anuthrak/eg-rocket-tvc/releases/batch-001_2026-10-30/drawings/SLDP-AV-001_avionic-sled.png

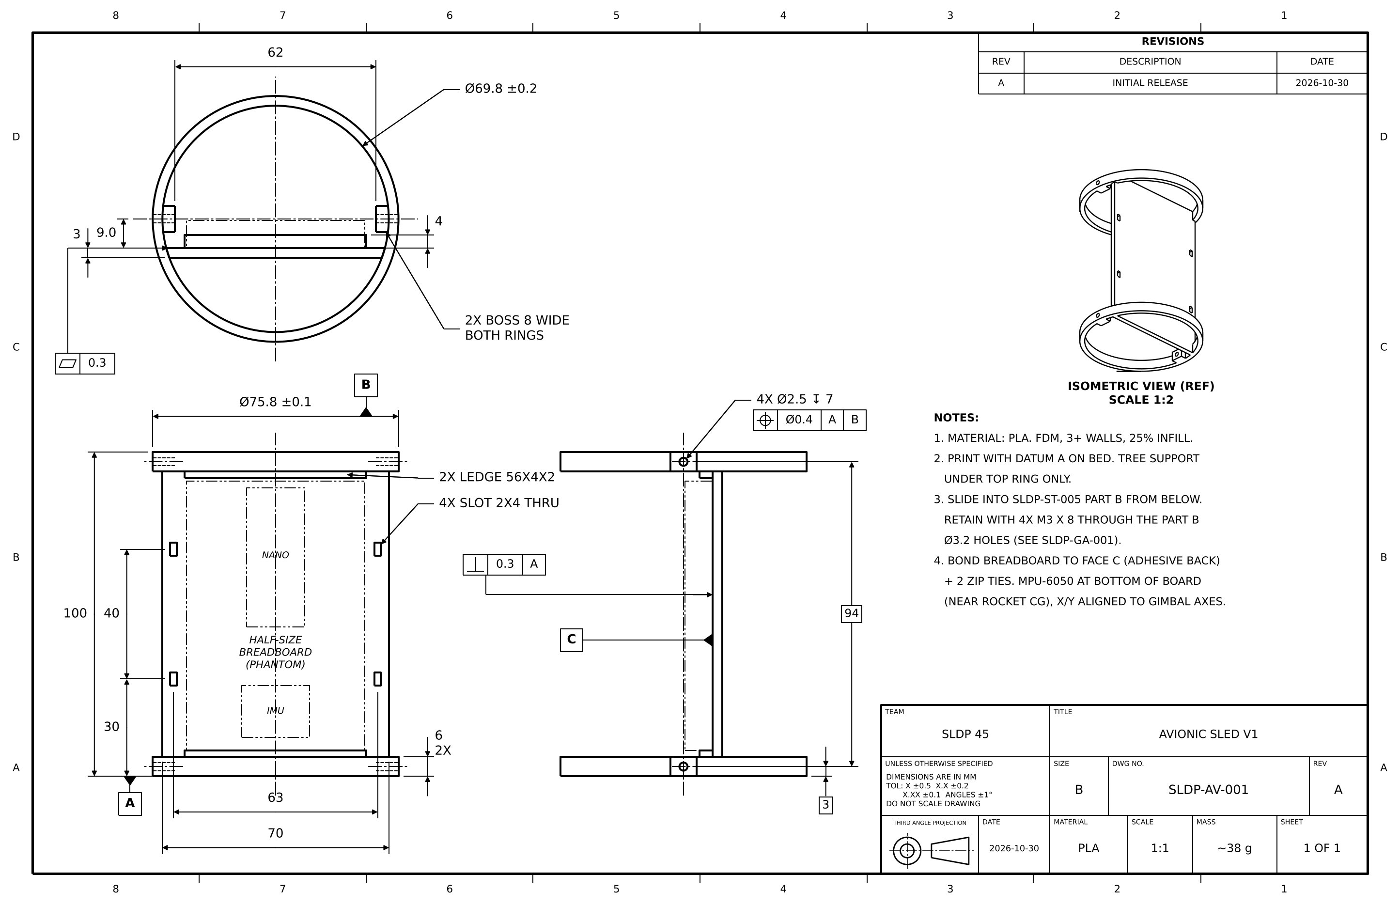
releases/batch-001_2026-10-30/drawings/SLDP-AV-001_avionic-sled.png
