anuthrak/eg-rocket-tvc/releases/batch-001_2026-10-30/drawings/SLDP-GA-001_rocket-ga_sheet2.png

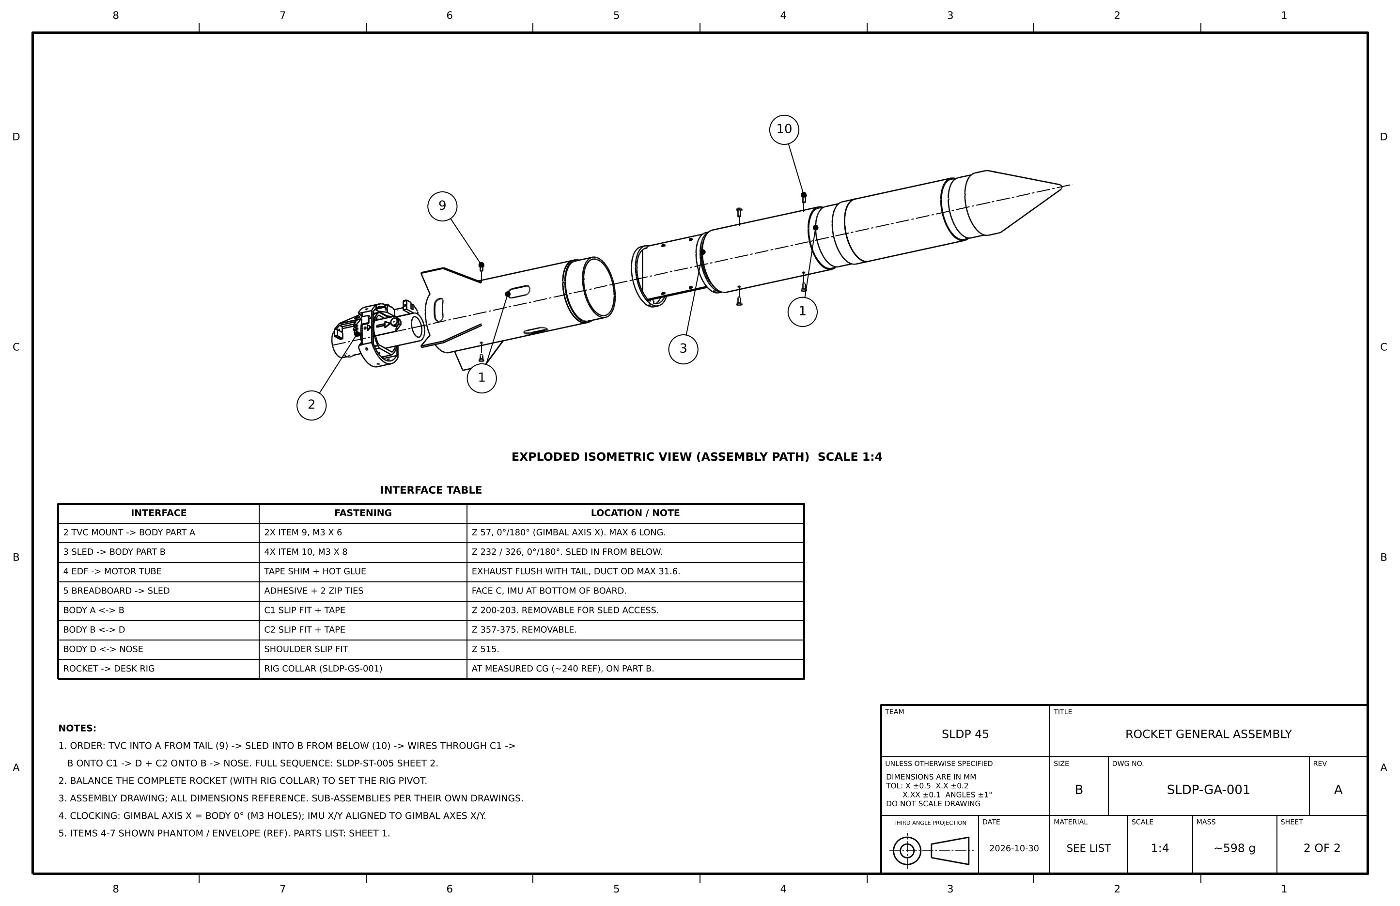
releases/batch-001_2026-10-30/drawings/SLDP-GA-001_rocket-ga_sheet2.png
