anuthrak/eg-rocket-tvc/releases/batch-001_2026-10-30/drawings/SLDP-TVC-001_tvc-mount-ga_sheet1.png

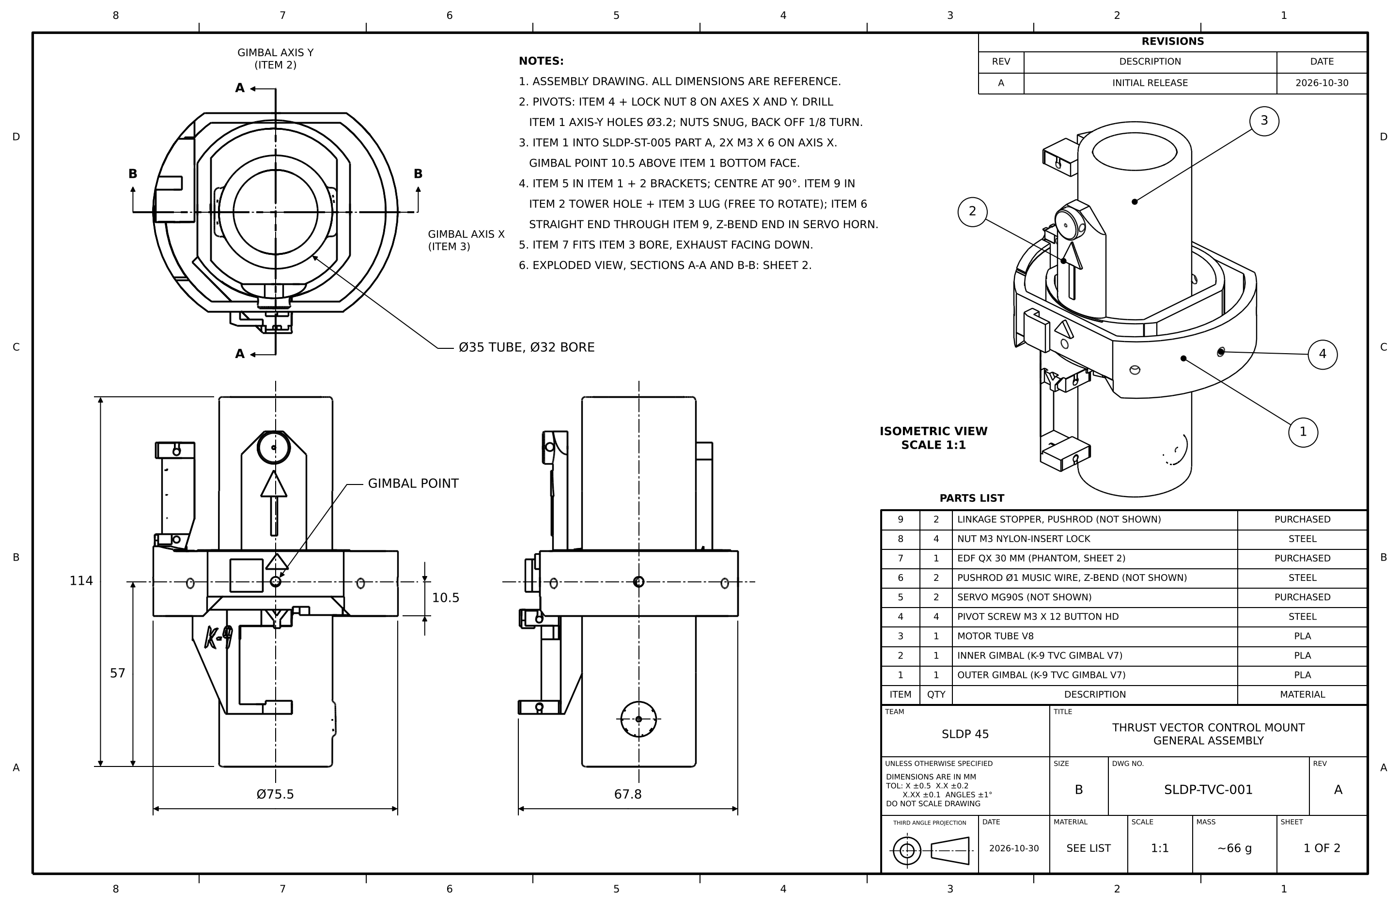
releases/batch-001_2026-10-30/drawings/SLDP-TVC-001_tvc-mount-ga_sheet1.png
