anuthrak/eg-rocket-tvc/releases/batch-001_2026-10-30/cad/SLDP-AV-001_avionic-sled.step

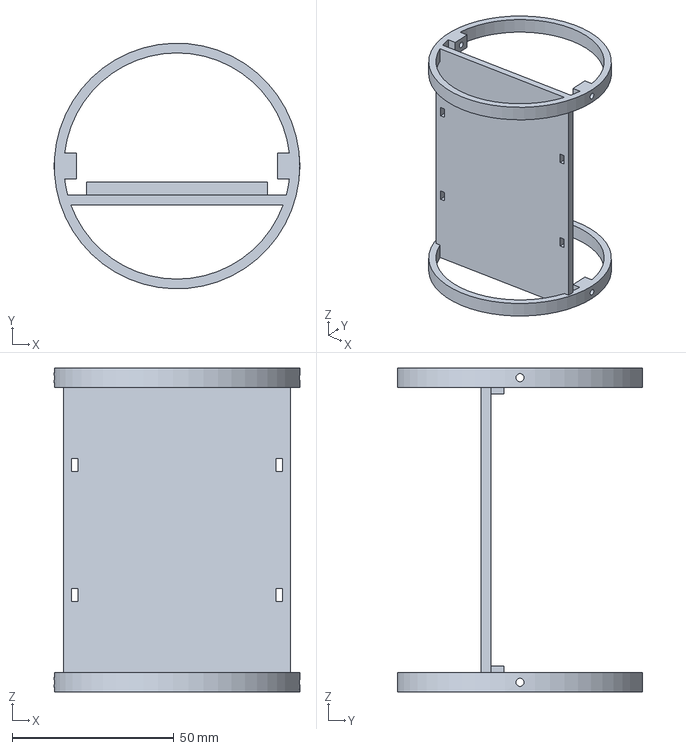
[picture p6: CAD file, 2026-11-02]
releases/batch-001_2026-10-30/cad/SLDP-AV-001_avionic-sled.step
75.8 x 75.8 x 100.0 mm
