anuthrak/eg-rocket-tvc/releases/batch-001_2026-10-30/print/SLDP-TVC-001_motor-tube-v8.stl

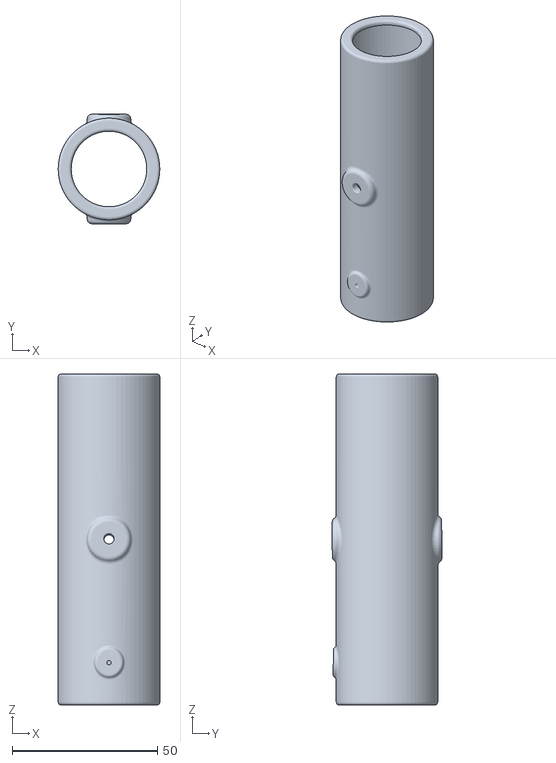
[picture p7: CAD file, 2026-11-02]
releases/batch-001_2026-10-30/print/SLDP-TVC-001_motor-tube-v8.stl
35.0 x 37.7 x 114.0
