anuthrak/eg-rocket-tvc/releases/batch-001_2026-10-30/cad/SLDP-ST-005_C2-interstage-coupler.step

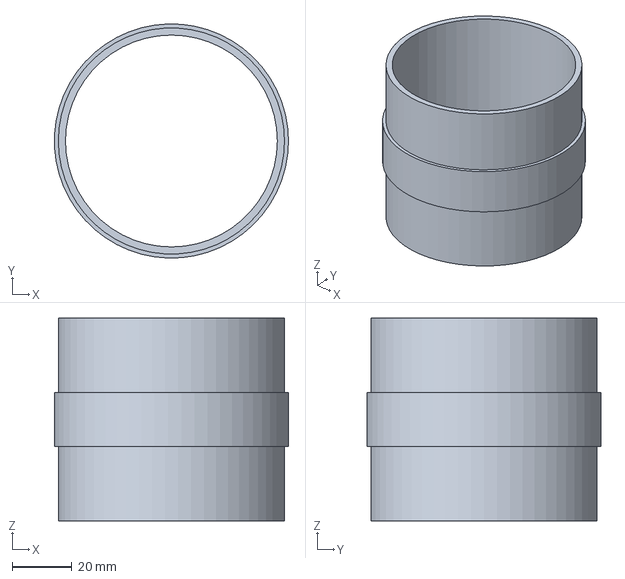
[picture p8: CAD file, 2026-11-02]
releases/batch-001_2026-10-30/cad/SLDP-ST-005_C2-interstage-coupler.step
78.5 x 78.6 x 68.0 mm
