anuthrak/eg-rocket-tvc/releases/batch-001_2026-10-30/print/SLDP-ST-005_D-upper-body.stl

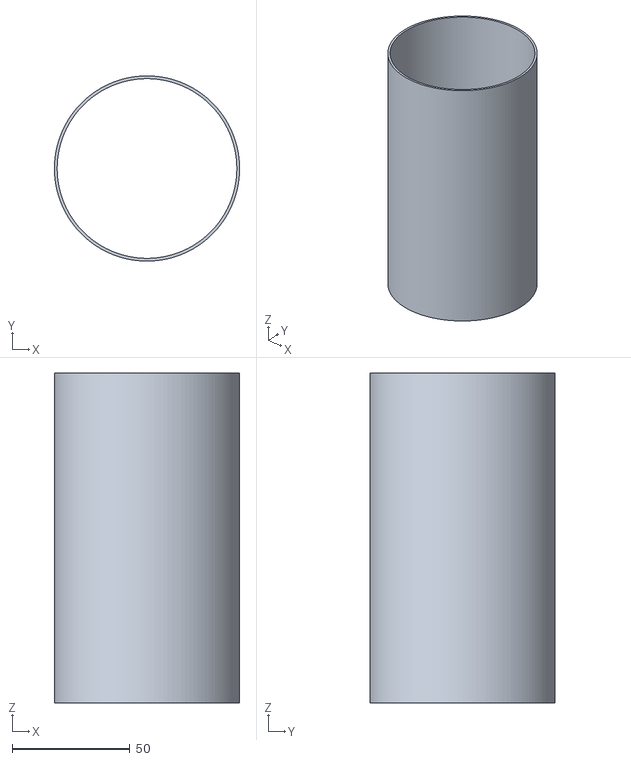
[picture p9: CAD file, 2026-11-02]
releases/batch-001_2026-10-30/print/SLDP-ST-005_D-upper-body.stl
78.6 x 78.6 x 140.0
