anuthrak/eg-rocket-tvc/releases/batch-001_2026-10-30/cad/SLDP-ST-005_B-avionics-bay.step

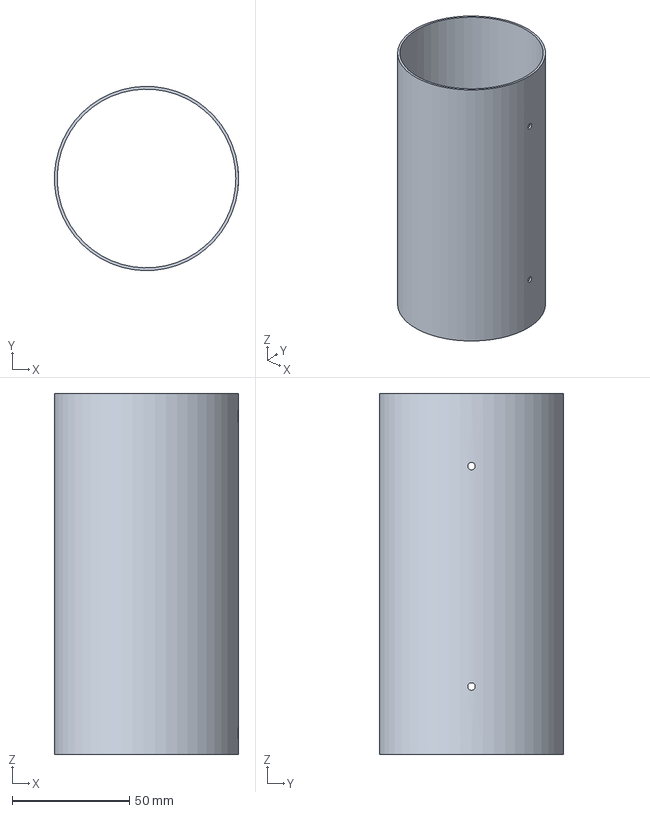
[picture p10: CAD file, 2026-11-02]
releases/batch-001_2026-10-30/cad/SLDP-ST-005_B-avionics-bay.step
78.6 x 78.6 x 154.0 mm
