anuthrak/eg-rocket-tvc/releases/batch-001_2026-10-30/print/SLDP-ST-005_E-nose-cone.stl

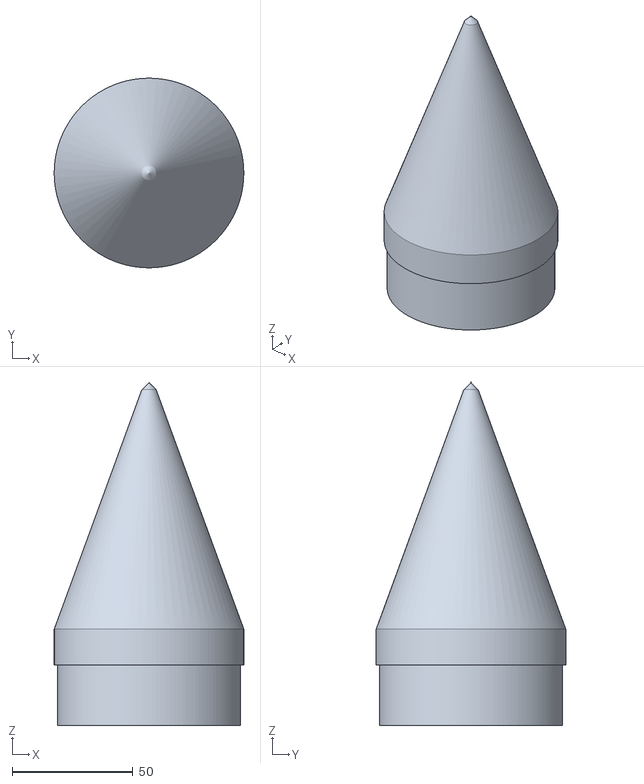
[picture p11: CAD file, 2026-11-02]
releases/batch-001_2026-10-30/print/SLDP-ST-005_E-nose-cone.stl
78.6 x 78.6 x 142.2
