anuthrak/eg-rocket-tvc/releases/batch-001_2026-10-30/print/SLDP-ST-005_test-coupler-C1.stl

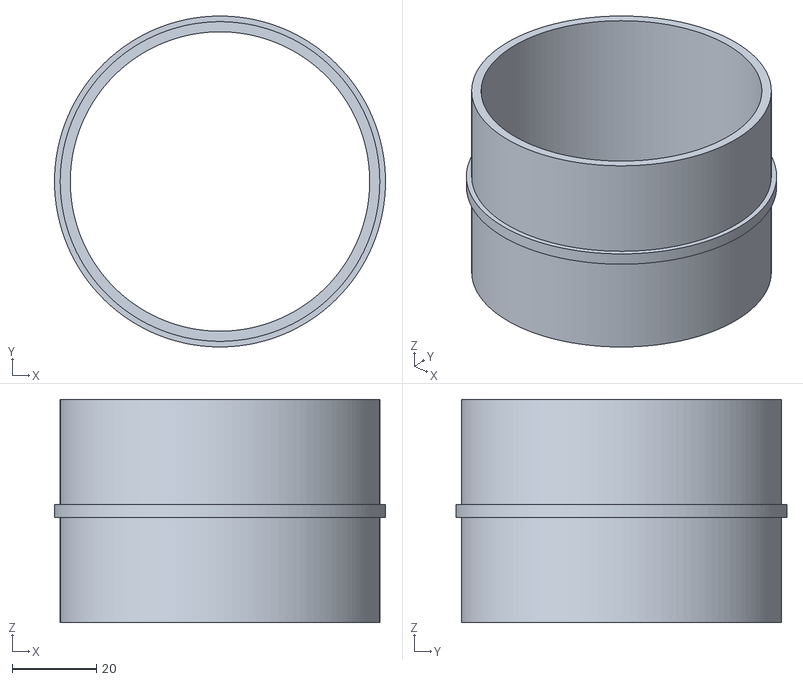
[picture p12: CAD file, 2026-11-02]
releases/batch-001_2026-10-30/print/SLDP-ST-005_test-coupler-C1.stl
78.6 x 78.6 x 53.0
