anuthrak/eg-rocket-tvc/releases/batch-001_2026-10-30/drawings/SLDP-GA-001_rocket-ga.pdf

B

## REVISIONS

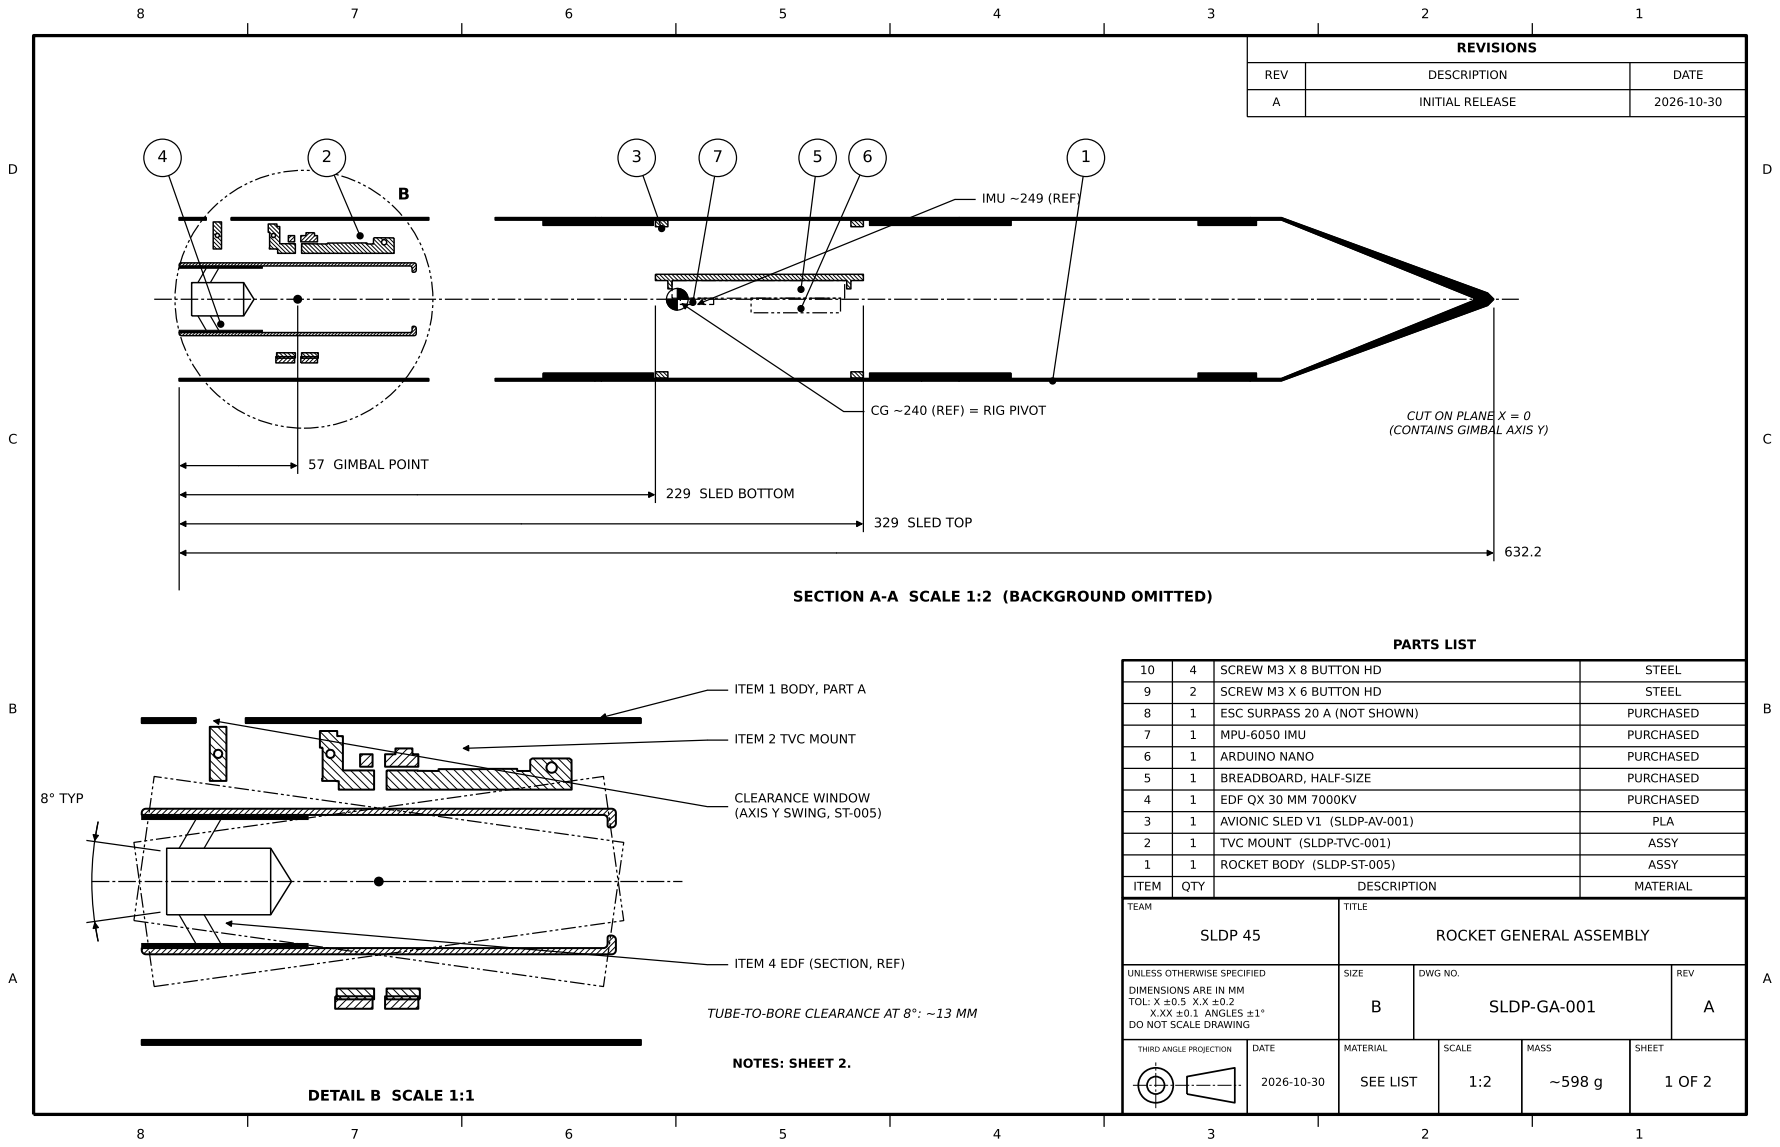
[picture p13: page 1]
57 GIMBAL POINT; 229 SLED BOTTOM; 329 SLED TOP; IMU ~249 (REF); 8° TYP; DETAIL B SCALE 1:1; NOTES: SHEET 2.; REV; DESCRIPTION; DATE; INITIAL RELEASE; TEAM; SLDP 45; TITLE; SIZE; DWG NO.; SLDP-GA-001; MATERIAL; SEE LIST; SCALE; MASS; SHEET; ITEM; QTY; ROCKET BODY (SLDP-ST-005); ASSY; TVC MOUNT (SLDP-TVC-001); AVIONIC SLED V1 (SLDP-AV-001); PLA; EDF QX 30 MM 7000KV; PURCHASED; BREADBOARD, HALF-SIZE; ARDUINO NANO; MPU-6050 IMU; ESC SURPASS 20 A (NOT SHOWN); SCREW M3 X 6 BUTTON HD; STEEL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

CG ~240 (REF) = RIG PIVOT

CUT ON PLANE X = 0
(CONTAINS GIMBAL AXIS Y)

SECTION A-A SCALE 1:2 (BACKGROUND OMITTED)

ITEM 1 BODY, PART A

ITEM 2 TVC MOUNT

CLEARANCE WINDOW
(AXIS Y SWING, ST-005)

ROCKET GENERAL ASSEMBLY

ITEM 4 EDF (SECTION, REF)

UNLESS OTHERWISE SPECIFIED

DIMENSIONS ARE IN MM
TOL: X ±0.5 X.X ±0.2
X.XX ±0.1 ANGLES ±1°
DO NOT SCALE DRAWING

TUBE-TO-BORE CLEARANCE AT 8°: ~13 MM

THIRD ANGLE PROJECTION

9

10

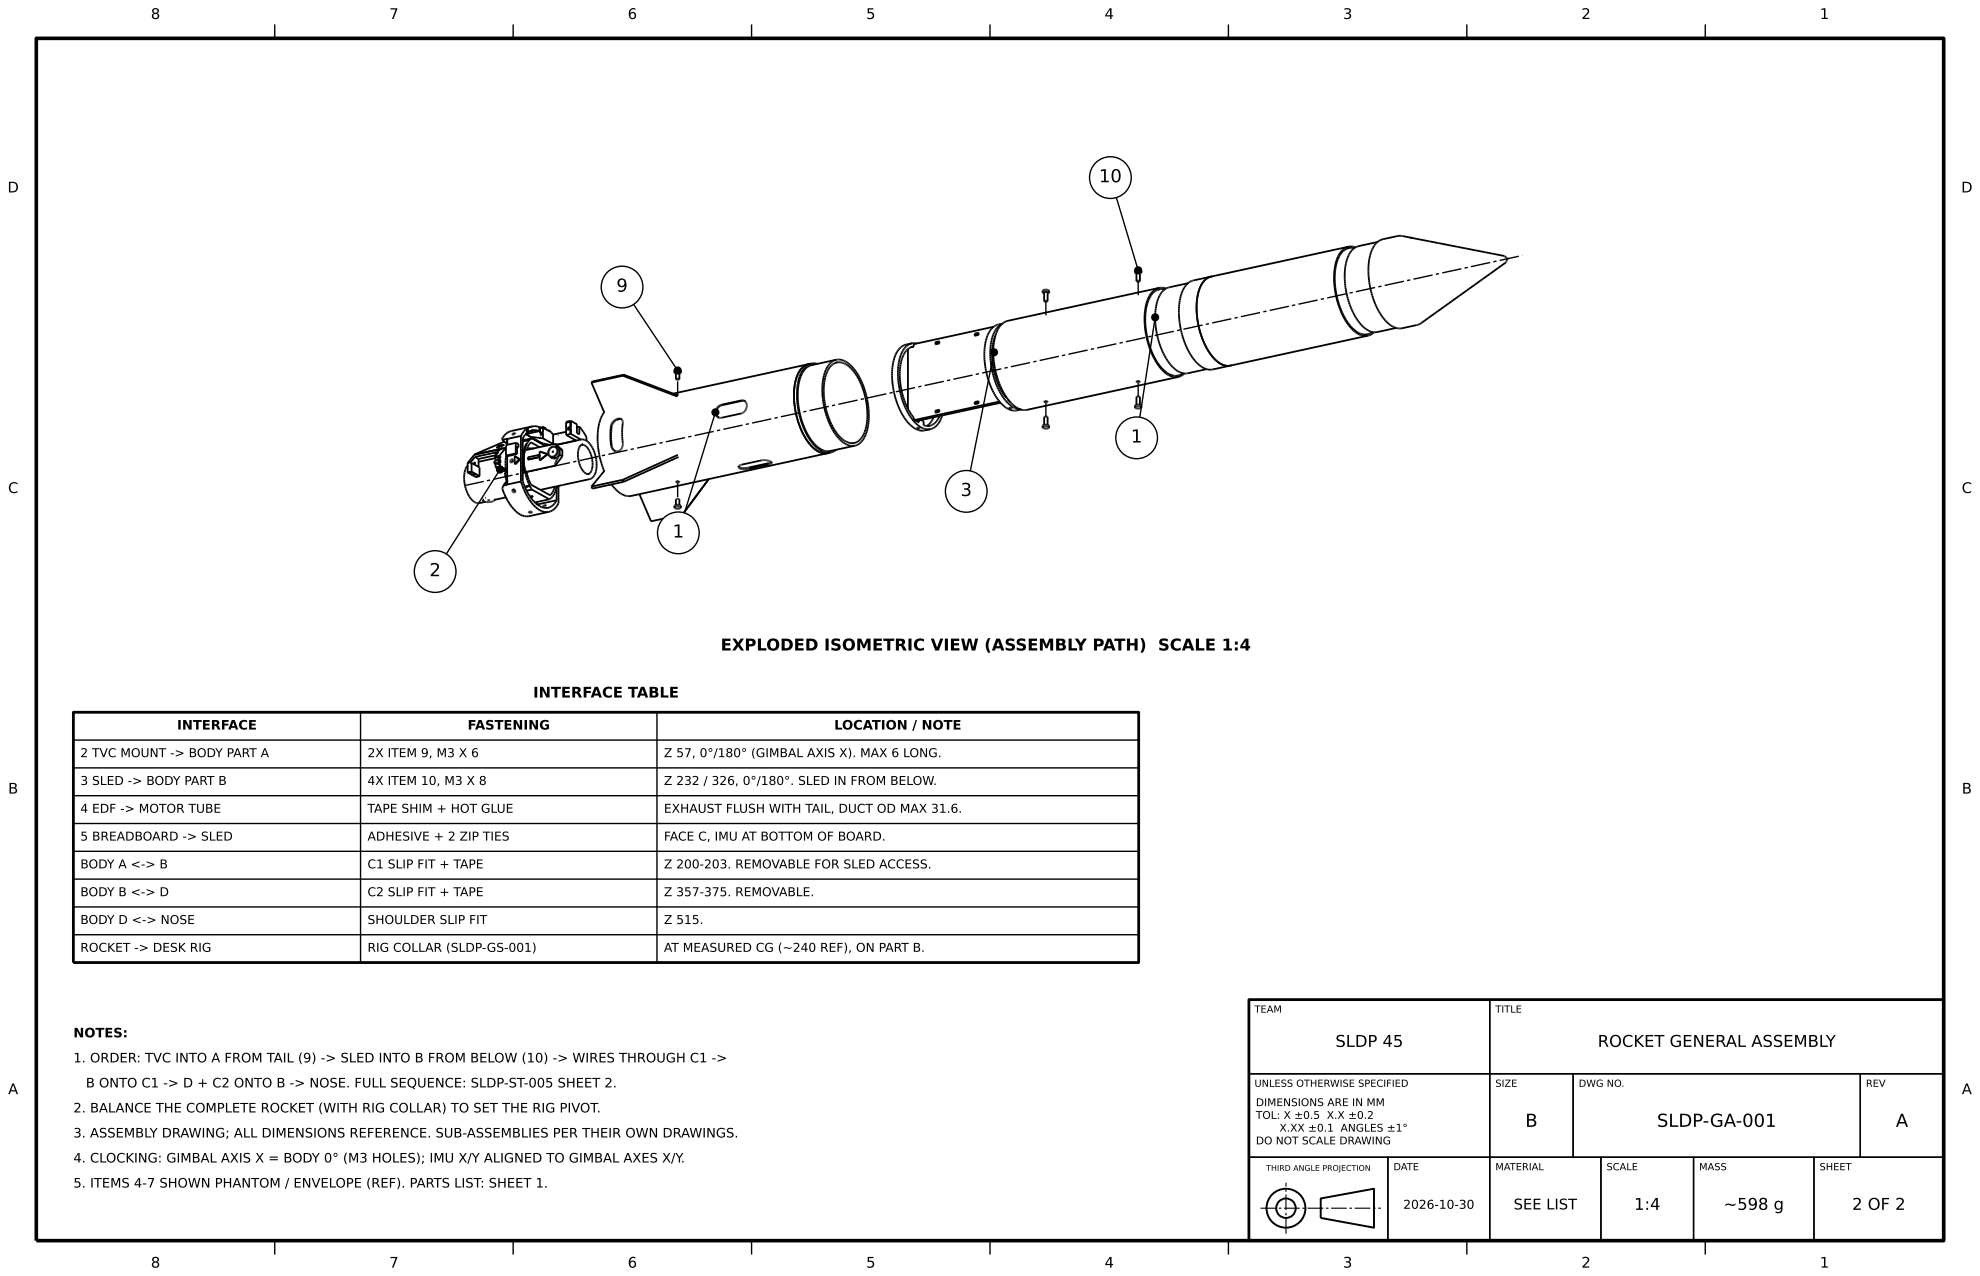
[picture p14: page 2]
INTERFACE; FASTENING; LOCATION / NOTE; 2 TVC MOUNT -> BODY PART A; 2X ITEM 9, M3 X 6; Z 57, 0°/180° (GIMBAL AXIS X). MAX 6 LONG.; 3 SLED -> BODY PART B; 4X ITEM 10, M3 X 8; Z 232 / 326, 0°/180°. SLED IN FROM BELOW.; 4 EDF -> MOTOR TUBE; TAPE SHIM + HOT GLUE; EXHAUST FLUSH WITH TAIL, DUCT OD MAX 31.6.; 5 BREADBOARD -> SLED; ADHESIVE + 2 ZIP TIES; FACE C, IMU AT BOTTOM OF BOARD.; BODY A <-> B; C1 SLIP FIT + TAPE; Z 200-203. REMOVABLE FOR SLED ACCESS.; BODY B <-> D; C2 SLIP FIT + TAPE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

EXPLODED ISOMETRIC VIEW (ASSEMBLY PATH) SCALE 1:4

ROCKET GENERAL ASSEMBLY

1. ORDER: TVC INTO A FROM TAIL (9) -> SLED INTO B FROM BELOW (10) -> WIRES THROUGH C1 ->

B ONTO C1 -> D + C2 ONTO B -> NOSE. FULL SEQUENCE: SLDP-ST-005 SHEET 2.

UNLESS OTHERWISE SPECIFIED

2. BALANCE THE COMPLETE ROCKET (WITH RIG COLLAR) TO SET THE RIG PIVOT.

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

3. ASSEMBLY DRAWING; ALL DIMENSIONS REFERENCE. SUB-ASSEMBLIES PER THEIR OWN DRAWINGS.

4. CLOCKING: GIMBAL AXIS X = BODY 0° (M3 HOLES); IMU X/Y ALIGNED TO GIMBAL AXES X/Y.

THIRD ANGLE PROJECTION

5. ITEMS 4-7 SHOWN PHANTOM / ENVELOPE (REF). PARTS LIST: SHEET 1.
