anuthrak/eg-rocket-tvc/(commit log)

2026-10-26 Restyle visualizer: black panels, condensed type, color-coded readouts, status pills
    Adds max pitch/yaw readouts, a link clock and feed rate in the header, a chart grid, and green done/next markers on the mission timeline. Layout and functions unchanged.
2026-10-26 Bring back the bottom mission HUD; freeze header layout
    Wide screens show the round gauges, big clock and timeline again. The top strip now carries only what the bottom HUD doesn't: next event with countdown, max speed, max altitude, peak gimbal, engine state. Header: labels that swap text get a min-width of their longest version, the status strip uses fixed-width value slots, and the demo pill's space is always reserved, so nothing shifts when switching tabs or as digits change.
2026-10-26 Fit the overview camera to the area not covered by HUD panels
    The overview now measures the gap between the bench panel, minimap/events list, controls and bottom HUD, centres the picture there with a view offset, and zooms out until Earth, the transfer orbit and the Moon fit inside it.
2026-10-26 Add loading screen with two looks (fuel, mission arc) and a temporary preview toggle
    Fuel: line drawing of the bench rocket whose two tanks fill with the pitch-blue and yaw-orange data colours, finishing with a ±8° nozzle gimbal check. Arc: the Earth-to-Moon path traced by the ship marker, ticking off milestones, finishing with a touchdown ring. Progress follows the real load steps (Three.js download, bench rig, Earth and Moon textures, transfer orbit); it's timer-driven so it completes in background tabs, shows for at least 1 s, skips the finale on same-session reloads, and lets a click dismiss it if the 3D library hasn't arrived after 15 s. Footer buttons (temporary) replay either look a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
2026-10-26 Split visualizer into six files; move firmware; add versioning
    visualizer/: index.html (markup), style.css, loader.js, main.js (entry, tabs, VERSION), bench.js (initBench), mission.js (initMission). Same behaviour; nothing runs on import, main.js calls each part in order and reports loader steps.
    Firmware moved to firmware/nano_tvc/nano_tvc.ino with FW_VERSION 1.0.0 printed at boot; the LINK panel shows it. Fuel loader is always the default (footer buttons only replay). Fixes the Bench header wrapping onto two lines at some widths. Adds CHANGELOG.md and README sections for the layout, running locally and releasing.
2026-10-26 Compact Mission tab top on phones: one-line header, icon controls
    Phones and short windows: title shortens to TVC, status shrinks to its dot, Connect + baud hide where USB Web Serial can't work, sim and bench controls become line-icon buttons (labels kept for screen readers), the mini bench panel is replaced by a one-line P/Y readout, and callouts move up. Desktop is unchanged.
2026-10-26 Mission first and default; Bench gets left and right sidebars
    Tab order is Mission, Bench; a fresh visit opens Mission (returning Bench visitors still get Bench). Bench sidebar split around the 3D view: left = readouts, chart (fills spare height), input options; right = gimbal and link tables plus help. Neither sidebar scrolls down to ~640px-tall windows: below 820px tall the help box moves into Connect's tooltip and rows tighten. Shorter roll footnote and servo-mode label; help text no longer mentions the removed Processing sketch. Keeps the page title rename.
2026-10-26 Bench: gimbal dial and serial log; smoother loading bar
    Right sidebar: a gimbal dial (nozzle position inside the ±45° ring, with a short trail) tops the Gimbal panel, and a serial log (last 200 lines, follows new lines unless scrolled up, boot messages highlighted) replaces the single-line box and fills the remaining height. Help shows only on screens >= 1000px tall (otherwise it's Connect's tooltip); baud/format rows hide below 820px since they're in the header.
    Loader: eases toward each checkpoint with a speed limit and keeps creeping toward the next one, runs on animation frames when visible (timer when hidden, where it skips easing), and texture generation works in ~50 ms slices so th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
2026-10-26 Keep the Mission camera out of planets; limit Bench zoom
    Mission: Earth and the Moon each get a thin springy shell above the surface. Dipping into it, the camera is pushed back out by a slightly underdamped spring (a small bounce, not a dead stop), sub-stepped so it behaves the same at any frame rate; a hard floor just above the surface means it can never get inside. Shells sit below the pad and landing heights so the low chase views still work.
    Bench: orbiting stays a free 360 degrees; zoom is limited to 1.2-11 units (more on tall, narrow windows so the rocket still fits), in proportion to the 8x8 floor grid, and panning is fenced to the grid.
2026-10-27 Mission camera: stop-and-bounce instead of sliding; rocket and tower are solid
    Camera colliders now cover Earth, the Moon, the rocket stack (whole stack until stage separation, then the upper stage) and the launch tower. A frame whose orbit/zoom input pushes the camera deeper into a body's soft zone is rejected, so the camera stops where it touched instead of sliding along the surface; first contact gives a small outward kick, and a sub-stepped spring settles it at the zone edge. Camera mode switches skip the check so they can't be undone by it.
2026-10-27 Mission camera collisions: dead stop instead of bounce
    Removes the outward kick and spring, which jittered when users kept dragging into a body. Now a frame that would put the camera inside a clearance zone keeps only the parts of the move that don't (orbit around the target at the same height, zoom out), so the camera holds still where it touched while sideways orbiting and pulling away still work. If the scene itself moves the camera inside (e.g. the rocket), it's placed straight back on the edge. Clearances: Earth 0.2, Moon 0.1, rocket and tower 0.06.
2026-10-27 Intro transition after the loading screen; Launch loader preview
    When the loader fades, Mission opens with a camera fly-in from a wide shot of Earth to the chase view (~1.8 s, controls paused until it lands) while the HUD boots in: panels fade and rise one after another, the event list cascades and the timeline markers light up left to right. Bench gets the HUD boot only. Same-session reloads get a quick version (~0.4 s); 'reduce motion' keeps the plain fade.
    Footer gains a Launch preview: the fuel loader with an ignition + launch-out finale (plume lights, rocket shoots off-screen), followed by the transition.
    The 3D scenes now skip drawing while the loader fully covers them (after one war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
2026-11-01 Bench gimbal calibration; firmware v1.2.0 serial commands + EEPROM config
    - Bench: Gimbal -> Calibrate opens a five-step panel over the 3D view
    (centre, level, sensor axes, servo direction, save)
    - Firmware v1.2.0: CAL/RUN/GET/SET/LEVEL/PULSE/SAVE/LOAD/DEFAULTS over serial,
    config stored in EEPROM; servos named by axis (D9 = X, D10 = Y)
2026-11-02 Release v2.4.0
    Bench gimbal calibration and firmware v1.2.0; bump VERSION and date the changelog entry.
2026-11-02 Firmware v1.3.0: any IMU mounting, tilt abort, PID, writeMicroseconds
    - LEVEL detects which sensor axis is up; SET UP / SET ROT map the sensor to the rocket frame
    (CFG gains up,rot at the end); the calibration sensor step corrects a turned sensor itself
    - Tilt abort at 25 deg (ABORT,TILT / ABORT,CLEAR), shown in the serial log
    - PID with the project-summary starting gains, scaled by thrust; servo pulses in microseconds;
    linkage ratio default 4.0 (0.2-8) with a laser measuring helper in Calibrate -> Save
    - Axis naming documented against the drawings (X servo drives pivot axis Y)
2026-11-02 One repo for the whole project: CAD, drawing release, docs
    - cad/: CadQuery models and drawing generators, one copy of the shared helpers (cad/lib),
    vendor K-9 gimbal files; scripts find each other through cad/lib/paths.py
    - releases/batch-001_2026-10-30: drawings, print STLs and STEP, renamed to the hyphen convention
    - docs/: corrected project summary (budget, schedule, roles, requirements), BOM, updated drawing standard
    - README covers the whole project; CLAUDE.md maps the sources of truth
    - Submissions, admin and old iterations stay local (gitignored)
2026-11-05 Firmware v1.4.0: tilt abort off for hand testing
    Add TILT_ABORT_ENABLED (false) so the gimbal keeps steering at any tilt,
    clamped to +-8 deg. The abort code is unchanged; turn it back on before
    the motor runs.
2026-11-05 Free-test mode and trim fix; firmware v1.5.0
    FREE ON|OFF and a Bench button for tilting the rocket by hand: no tilt
    abort, half gains, same +-8 deg limit. It starts off at every restart and
    is never saved, so the abort is armed by default again.
    SET ROT now turns the level trims with the sensor mapping, so an upright
    rocket still reads upright after the sensor step.
2026-11-05 Keep the Gimbal header buttons on one line in narrow panels
2026-11-05 Bench model from the CAD; firmware v1.6.0 sends the tilt
    The bench rocket now uses the CAD proportions, parts, fins and CG pivot,
    with a motor tube that swings about the gimbal point. It leans by the real
    IMU tilt, and the tube shows servo deflection / linkage ratio.
    Telemetry adds tiltX,tiltY. Demo mode sends the same format, answering
    through the firmware's gains.
2026-11-05 Bench demo with real physics, thrust plume and arrow, tilt on the chart
    Demo mode simulates the rocket on its CG pivot with the design numbers and
    the firmware's controller: gusts knock it 10-19 deg and it recovers in about
    a second. The plume and force arrow are dim on the real rig, since no motor
    is wired yet. The chart shows tilt with the abort lines.
2026-11-05 Label the servo readouts X servo and Y servo
2026-11-05 Chart labels: pitch and yaw tilt
2026-11-05 Revert "Label the servo readouts X servo and Y servo"
    This reverts commit 8a09e38657184809d632db33b0573abd02d27bbb.
2026-11-05 Release v2.7.0
    CAD-based bench model with real tilt, physics demo with drag and release, thrust plume and arrow, free-test mode, trim fix, firmware v1.6.0; bump VERSION and date the changelog entry.
2026-11-05 Mission: director camera, effects, nozzle close-up, Hit it, real controller
    Director camera cuts between shots through the flight, with stage separation
    in slow motion. Adds camera shake, flash and engine glow, pad smoke, Max-Q
    vapour, separation puffs and landing dust, a live nozzle close-up, and a Hit it
    button that reports the recovery.
    The Mission and the Bench demo now share controller.js, the firmware's
    algorithm and gains, replacing the Mission's own PD controller. The flight path
    stays scripted.
2026-11-05 Mission: slightly less camera shake
2026-11-05 Mission: fix the landing legs
    They swung inward through the body and were too short to reach the ground.
    They now stow against the body, swing out and down, and reach the surface.
2026-11-05 Mission: onboard and overhead shots in the director
    Onboard cameras look back down the rocket during ascent, after separation and
    as the legs deploy, with the engine light dimmed in those shots. An overhead
    shot looks down on the rocket in lunar orbit.
2026-11-05 Mission: onboard cameras point straight back along the body
    Adds a short down-looking shot during the countdown.
2026-11-05 Mission: rework the onboard camera
    Mount it on the side facing away from the planet so the horizon is level and
    the fins look even, widen the lens, and show the engine as a soft glow past the
    body.
2026-11-05 Mission: onboard camera modelled on real rocket footage
    Mount it against the body near the tail with a wide lens, so the body is a low
    dome with the fins rising beyond it and the horizon running diagonally. Smooth
    the rocket body, which these shots see up close.
2026-11-05 Release v2.8.0
    Mission director camera with onboard and overhead shots, shake, pad and landing effects, nozzle close-up, Hit it, landing leg fix, and the firmware's controller in the Mission; bump VERSION and date the changelog entry.
2026-11-05 Mission: one hit at a time
    Back-to-back hits could stack up until the rocket tumbled. The button now waits
    for the recovery, measured against the target as it turns along the path.
2026-11-09 Calibrate: servo motion test (firmware v1.7.0 SWEEP)
